Ladranbe/Projet_Station_Meteo_Connectee/Documentation/IMG_0720.JPG

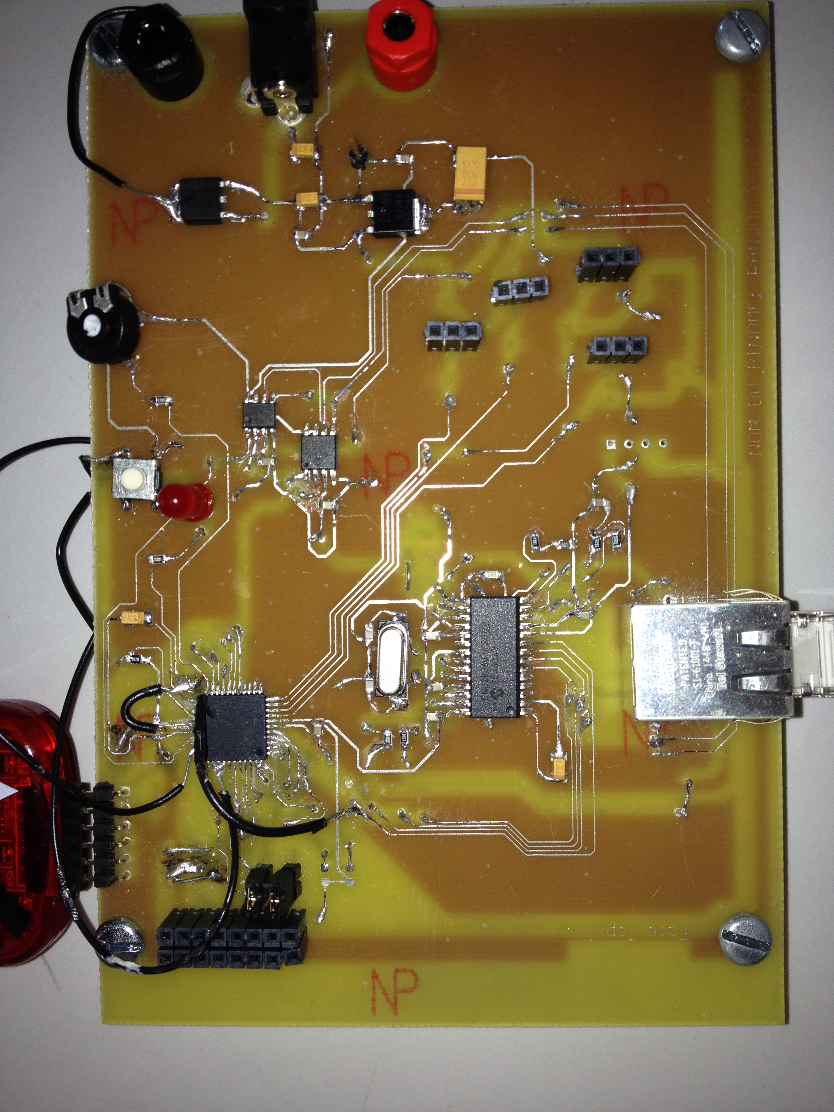
Documentation/IMG_0720.JPG
