Ladranbe/Projet_Station_Meteo_Connectee/README.md

# Projet_Station_Meteo_Connectee
School project hardware+software, prototype of a connected weather station
Hardware PCB with a Microchip PIC18 µC
Software TCP/IP Stack from Microchip modified

The project goal was to display data from different sensors on a web page
