Ladranbe/Projet_Station_Meteo_Connectee/Documentation/architectureHardware.pptx

PCB

Alimentation 230 V AC -> 9-12 V DC

Alimentation linéaire 5 V régulée

Alimentation linéaire 3,3 V régulée

µC

Contrôleur Ethernet

EEPROM (x2)

Connecteur RJ-45

Capteur température (x2)

Capteur hygrométrie (x2)

Anémomètre/girouette

Potentiomètre

LED

Bouton poussoir

Pickit 3

Connecteur debug
