Ladranbe/Projet_Station_Meteo_Connectee/Documentation/SchémaFonctionnel.pptx

Bloc acquisition de données

Carte à microcontrôleur PIC18F47J13
Contrôleur Ethernet
2 EEPROMs

Bloc traitement de données

Page WEB

Adresse IP

Bloc affichage des données

Intérieur

Capteur température
LM335Z

Capteur hygrométrie
HIH-4000-001

ADC

ADC

Ethernet

Extérieur

Capteur température
LM335Z

Capteur hygrométrie
HIH-4000-001

Anémomètre et girouette

ADC

ADC

RJ-11

Réseau Ethernet

Ethernet

## Slide 2


Sorties des capteurs
analogiques

Broches du PICkit

SPI

UART

Potentiomètre

Non utilisé

Non utilisé

CS des EEPROM

Broche du PICkit

CS du contrôleur Ethernet

Bouton poussoir

LED
