Ladranbe/Projet_Station_Meteo_Connectee/Documentation/Schéma-carte-eth_wifi (1).pdf

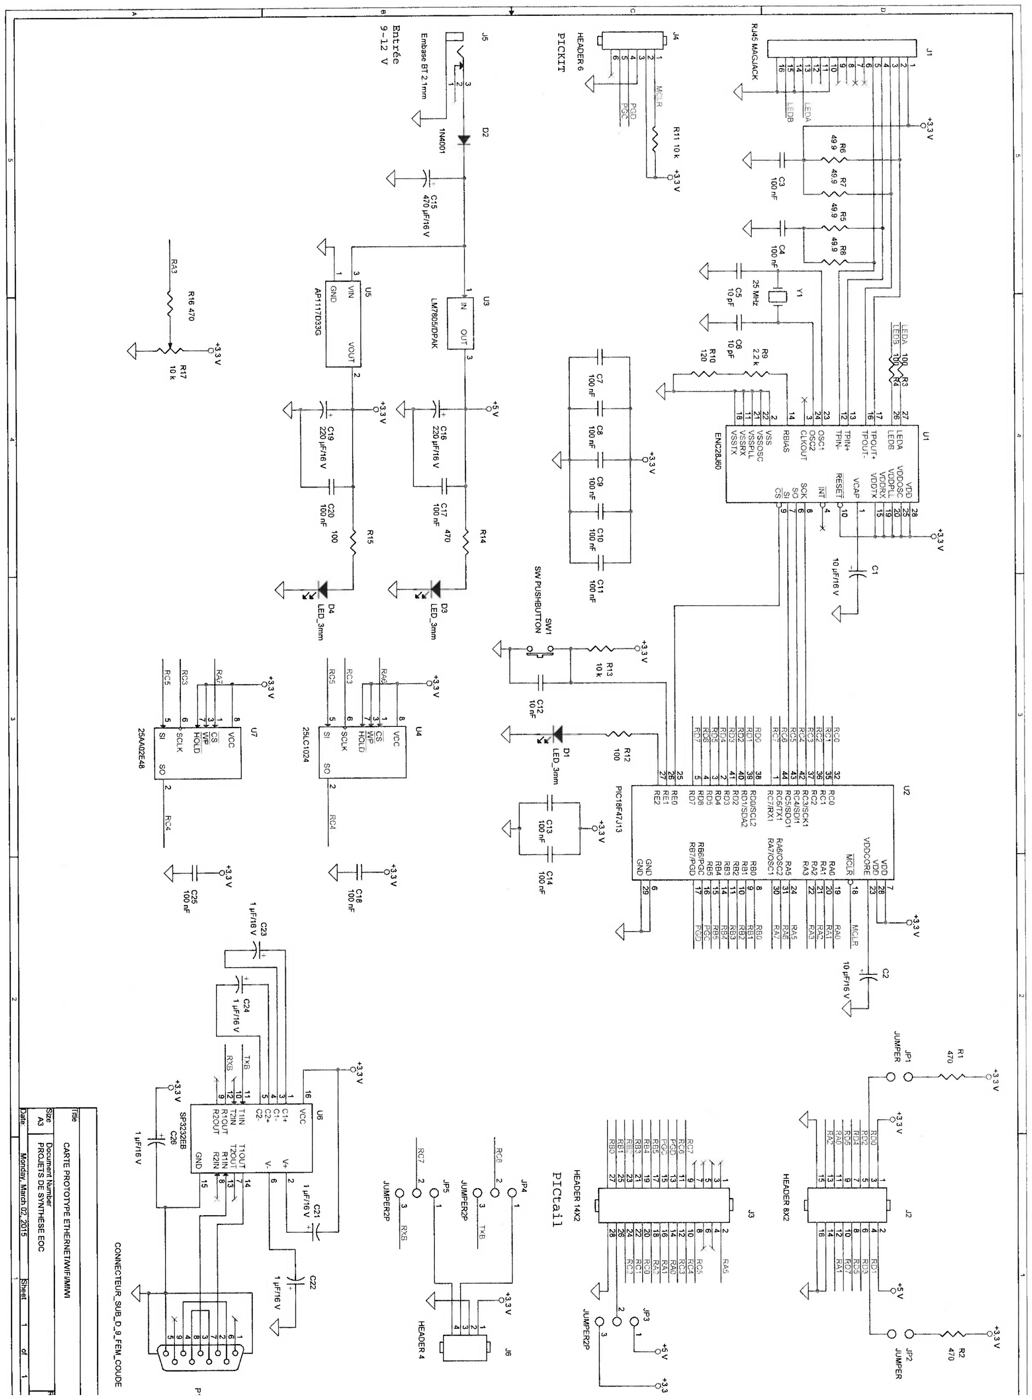
[picture p45: page 1]
