Ladranbe/Projet_Station_Meteo_Connectee/Documentation/EcranErreur.PNG

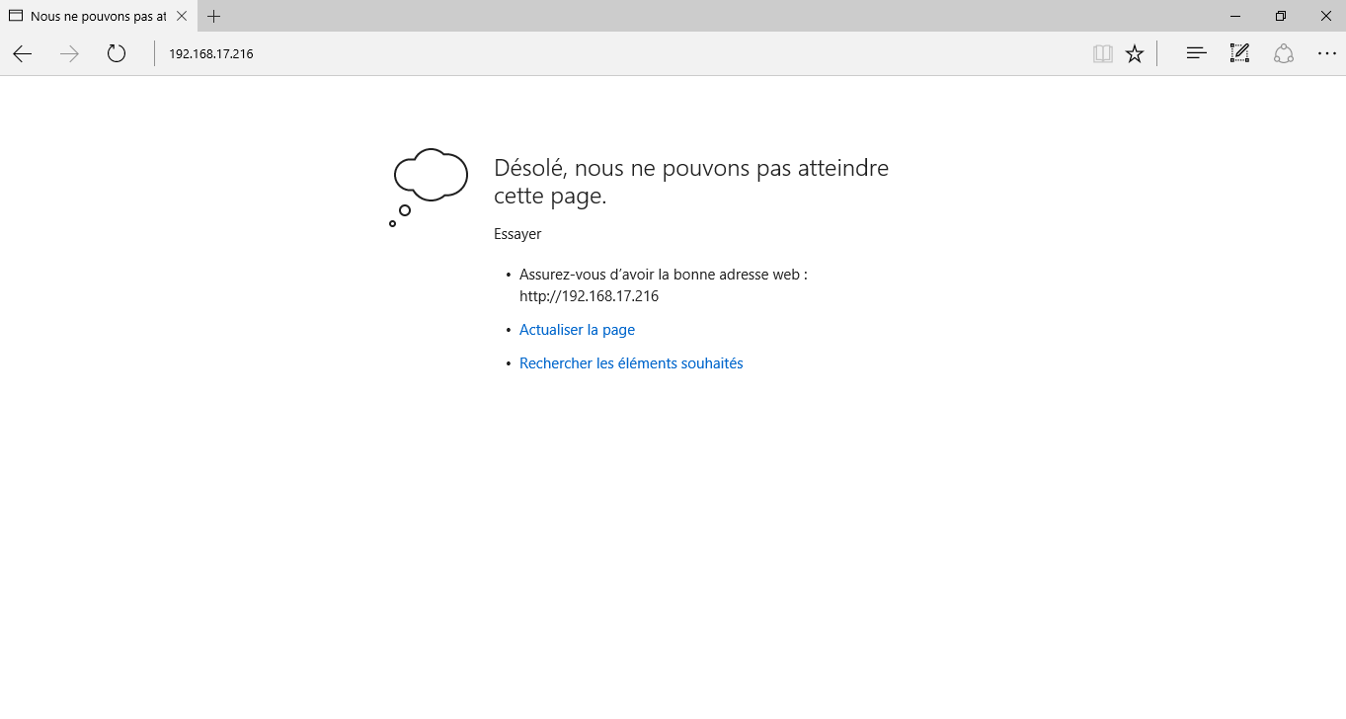
Documentation/EcranErreur.PNG
