Ladranbe/Projet_Station_Meteo_Connectee/Documentation/pageWebMicrochip.PNG

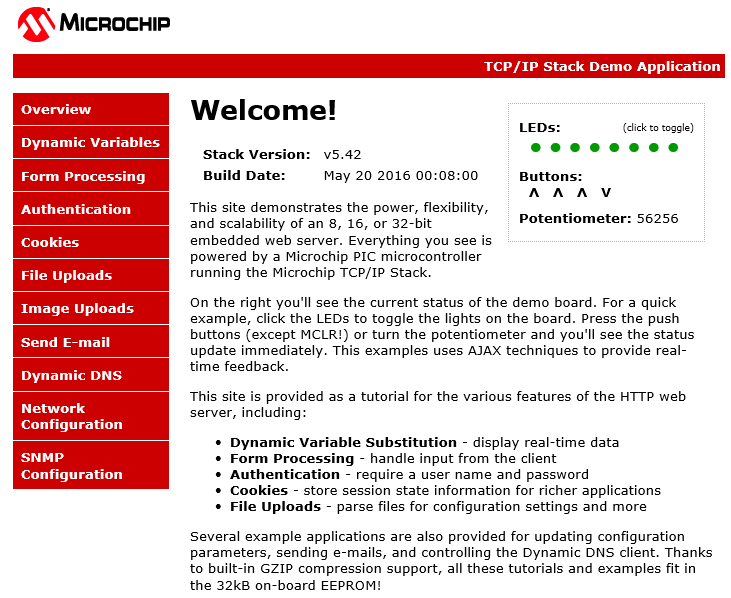
Documentation/pageWebMicrochip.PNG
