Ladranbe/Projet_Station_Meteo_Connectee/Documentation/pageWebNotreCarte.PNG

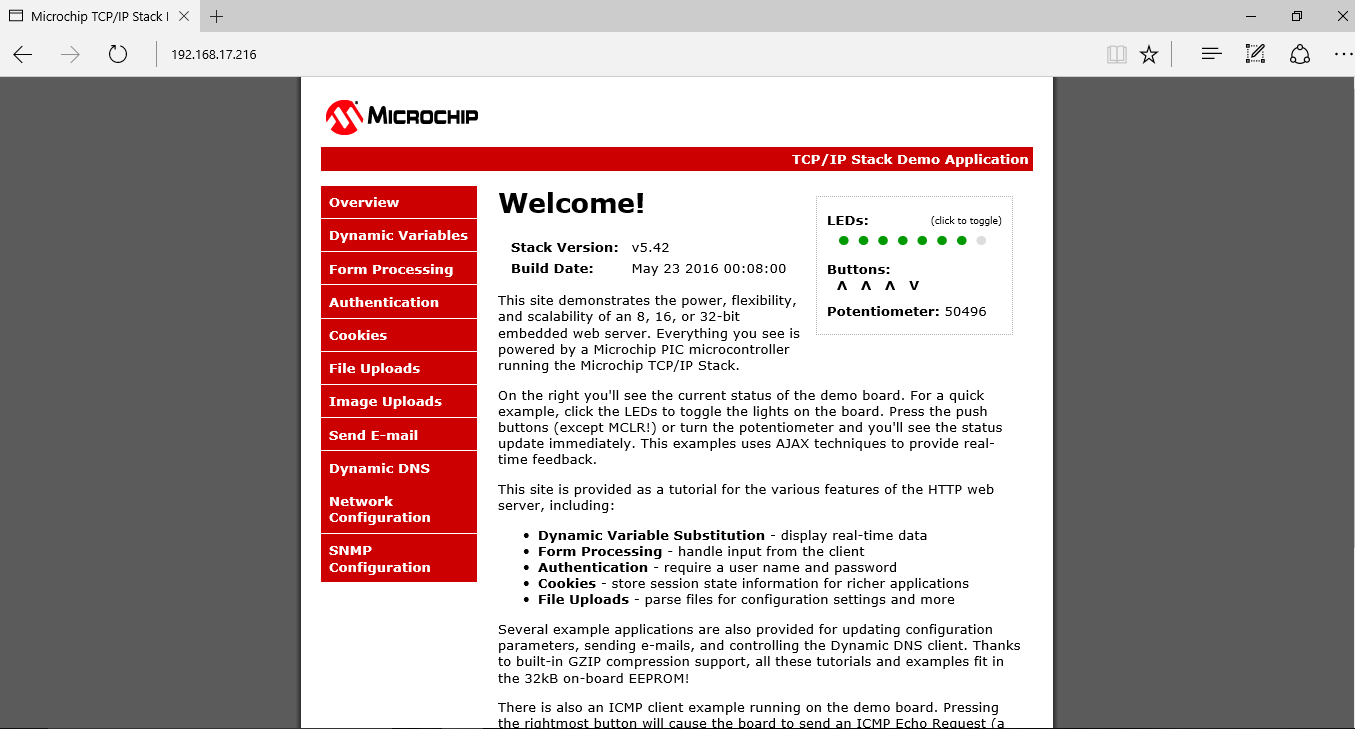
Documentation/pageWebNotreCarte.PNG
