Ladranbe/Projet_Station_Meteo_Connectee/Documentation/ping.PNG

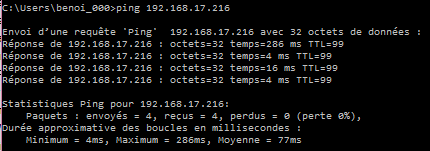
Documentation/ping.PNG
