Ladranbe/Projet_Station_Meteo_Connectee/AltiumFiles/projet_pcb_etu_formatA4.PDF

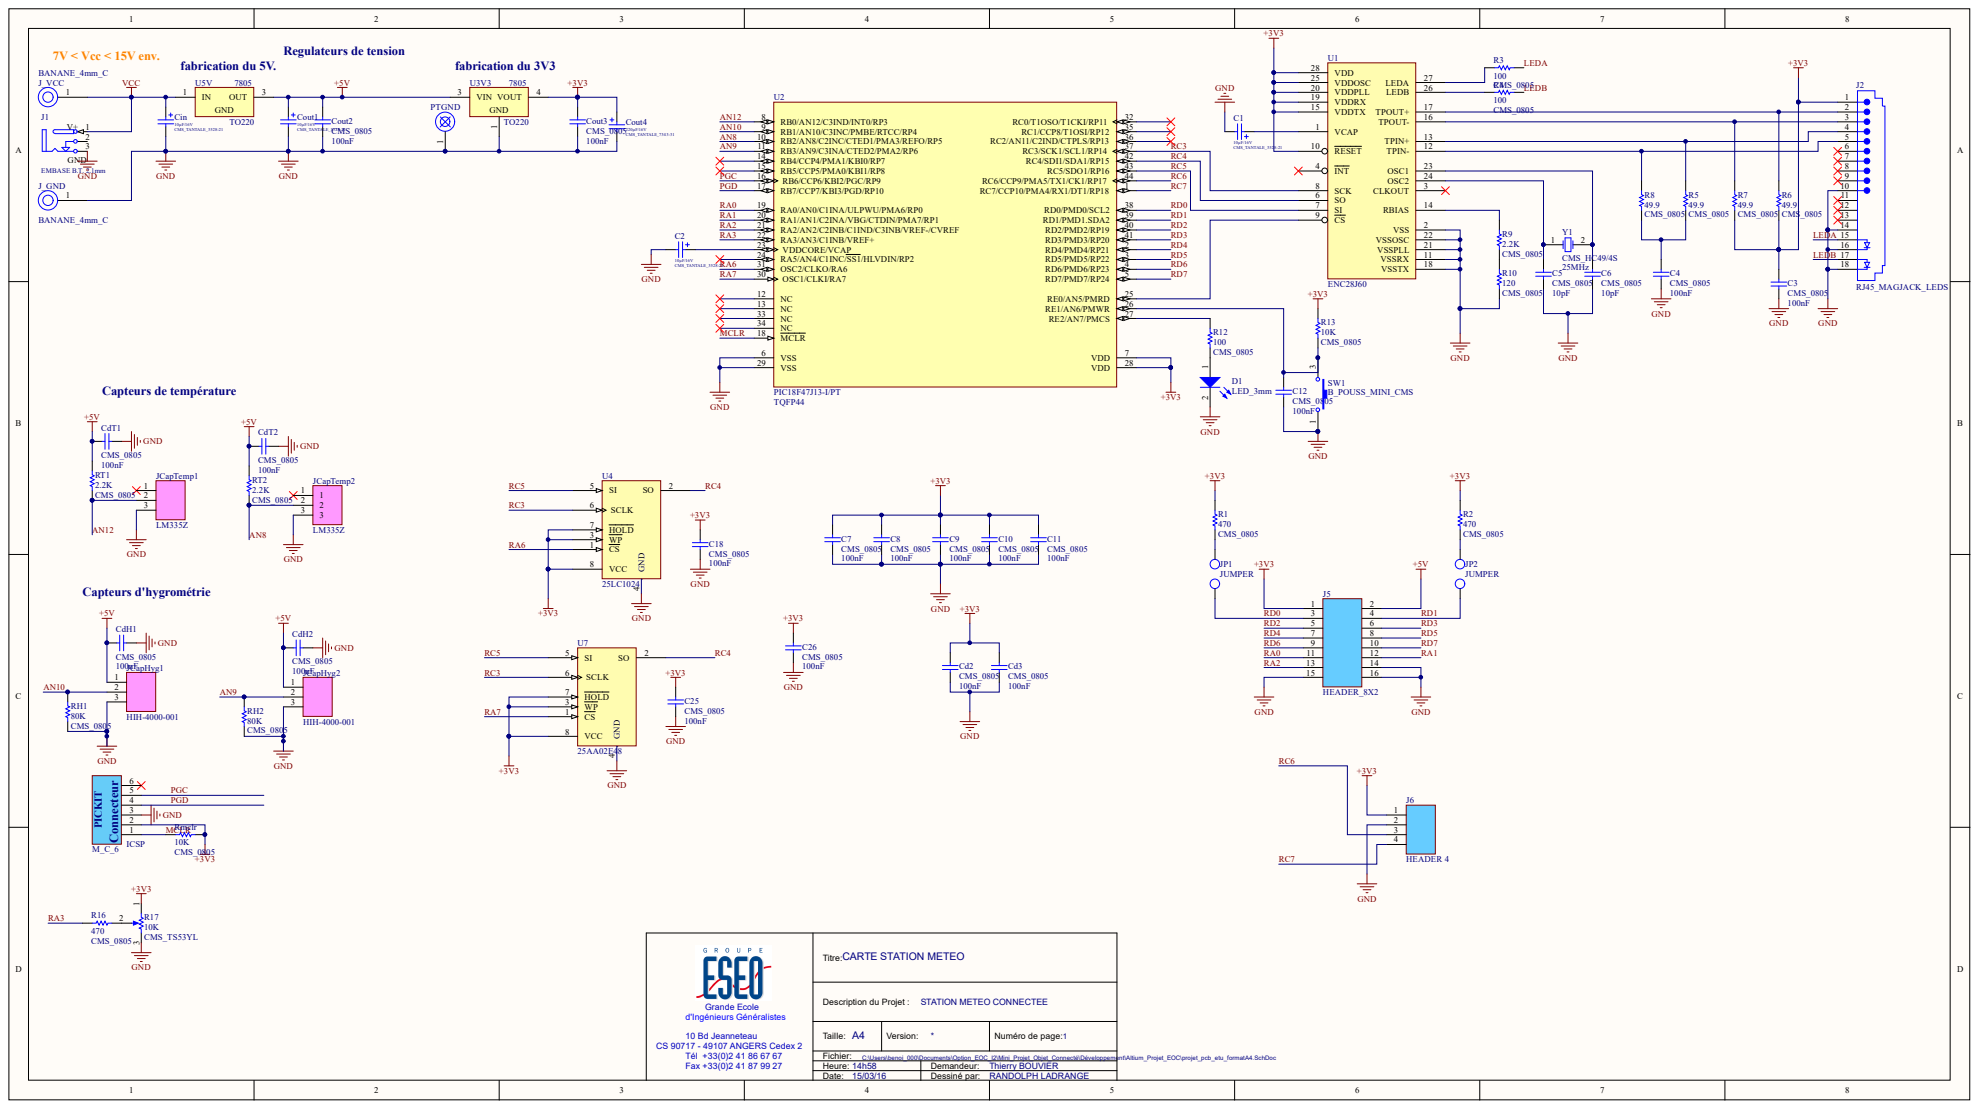
[picture p50: page 1]

H e ure : 1 4 h 5 8 | D ema n d e ur: T h i erry BO UVIER
D a t e : 1 5 / 0 3 / 1 6 | D essi n é p ar: RAN D O LPH LAD RAN G E

# Board S
