Ladranbe/Projet_Station_Meteo_Connectee/(list of files, drawings)

Other design files:
AltiumFiles/projet_pcb_etu.PCBDOC
AltiumFiles/projet_pcb_etu.PrjPCB
AltiumFiles/projet_pcb_etu_formatA4.SchDoc
