Ladranbe/Projet_Station_Meteo_Connectee/Software/declaration.h

/**
 * \file declaration.h
 * \brief quelques definitions de types.
 * \author S. Aubin
 * \version 0.1
 * \date 18/02/2013
 */

#ifndef __DECLARATION_H__
#define __DECLARATION_H__

/*taille variable*/
 #define UINT16 unsigned int //avec c18 un int est code sur 16bits
 #define UINT32 unsigned long int
 #endif
