Ladranbe/Projet_Station_Meteo_Connectee/(commit log)

2017-10-25 Add Altium files
    [projet_pcb_etu.PCBDOC, projet_pcb_etu.PrjPCB, projet_pcb_etu_formatA4.SchDoc]
2017-10-25 Add documentation files
    [Planning_effectif.xlsx, tableau_Etat_Avancement.xlsx]
